NickCulbertson/Mini-Teensy-Synth/MiniTeensyImage1.jpg

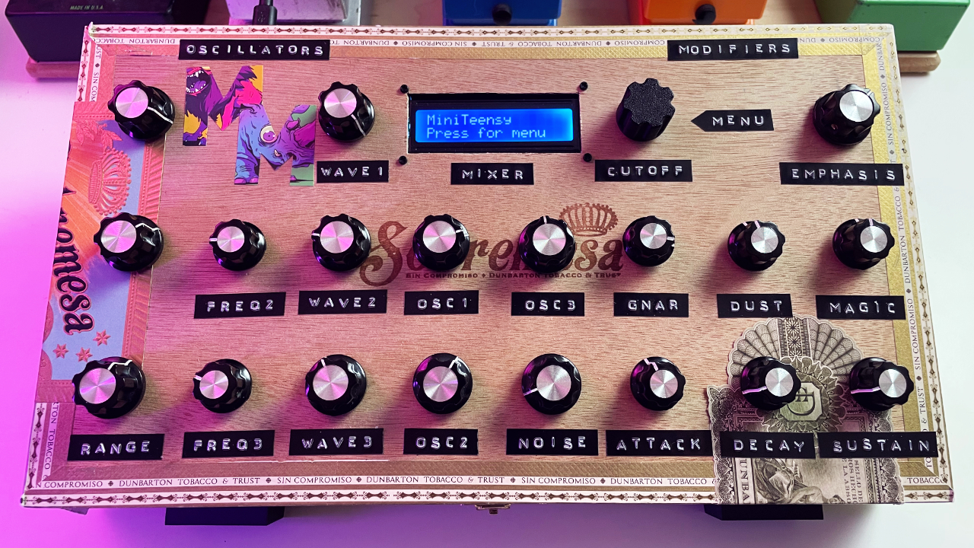
MiniTeensyImage1.jpg
