NickCulbertson/Mini-Teensy-Synth/(commit log)

2025-11-12 Add initial README for Mini Teensy Synth project
2025-11-24 Update README with parts list and links
    Added parts list with links for Teensy 4.1, menu encoder, LCD, and knobs.
2025-12-02 Flipped DT and CLK on menu encoder
    [Mini-Teensy-Synth.ino]
2025-12-13 Update pin assignments for encoders in README
2026-02-23 Move menu button to pin 16
    Pin 13 on the Teensy is for the LED. As a result I moved the menu button to pin 16 and the pin on 16 to 51 under the board. Of course these can be configured however you want in configs. This will help with button press reliability.
